brkelly6585/Open-Source-ARM-Cortex-M0/(commit log)

2025-11-17 Updated to run basic Data instructions
    Data Memory module added, needs to be connected with proper stall
    Branching needs set at default to fix lag at beginning of instructions
    Begin removing inital blocks in regfile
    [Data_Memory.v, IDEX.v, Instr_decode.v, arthALU.v, core.v]
2025-11-18 Updated flags and decoder
    Further Steps:
    Need to work on Memory Access, specifically how to stall 1 cycle between the ALU output and the Data Memory Access
    Need to set up branching along with driving the PC_branch wire
    Need to look into reset of core, see if the current set works properly
    [Instr_decode.v, Register_File.v, arthALU.v, core.v]
2025-11-18 Updates to decoding and flags
    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
2025-12-01 Updated instructions
    Only uploading the instruction mem with more data instructions for now. Unable to upload memory and branch operations since the current implementation causes cycle issues that are impacting data instructions. Leaving this as current working build.
2025-12-08 Fix Data instruction operations and cycles
    Core contains references to some Branch and Memory instructions, but they are untested so removed from final push.
    [IDEX.v, Instr_decode.v, Register_File.v, arthALU.v, core.v]
2026-07-20 Fix formatting and comments in clock_gen.v
    [clock_gen.v]
